jmax696/PillCard/docs/ER_Datenbank.png

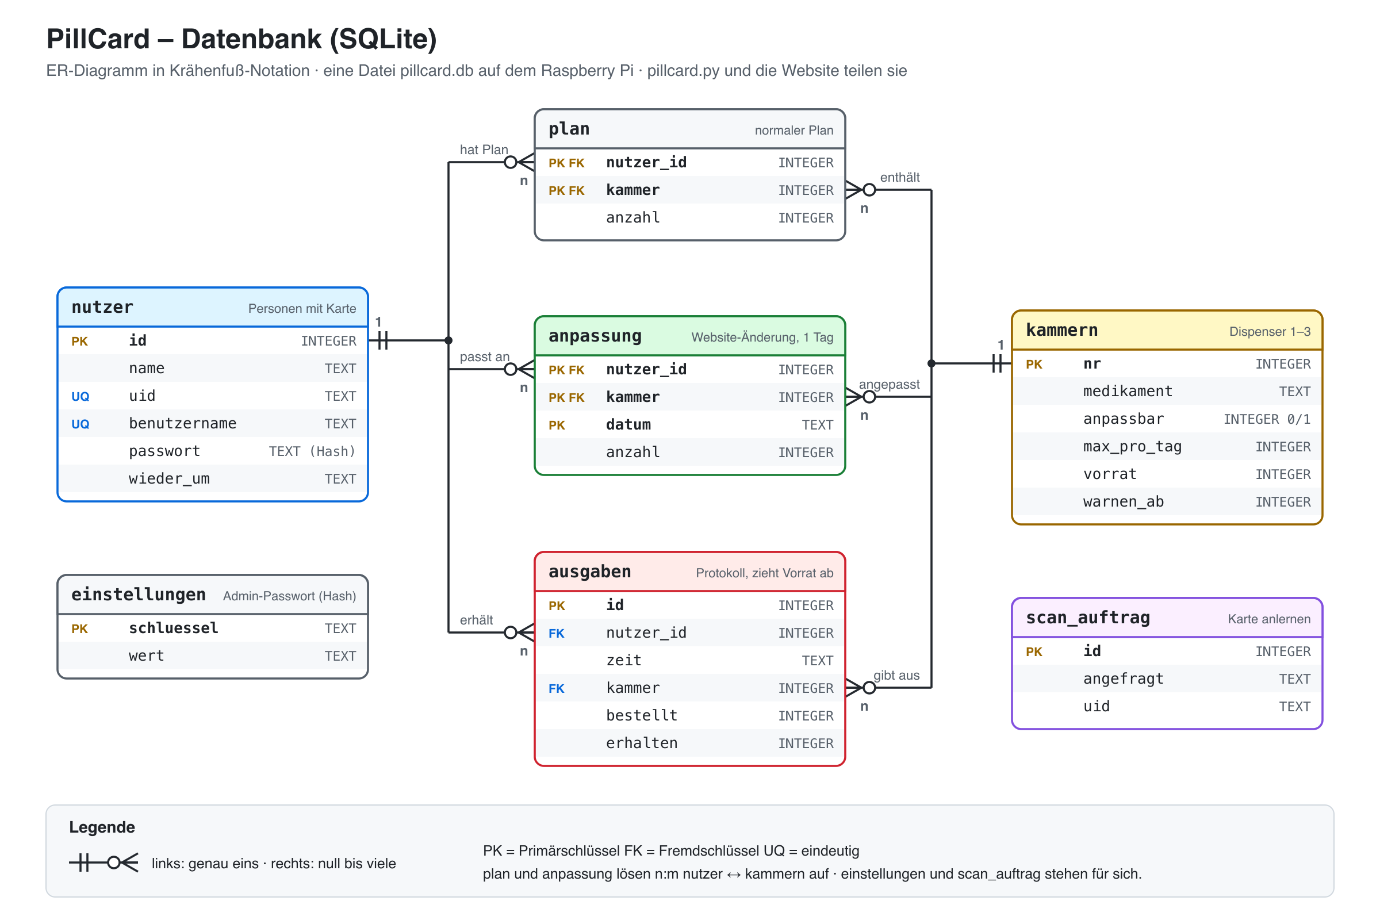
docs/ER_Datenbank.png
