jmax696/PillCard/docs/Schaltplan_ESP32.png

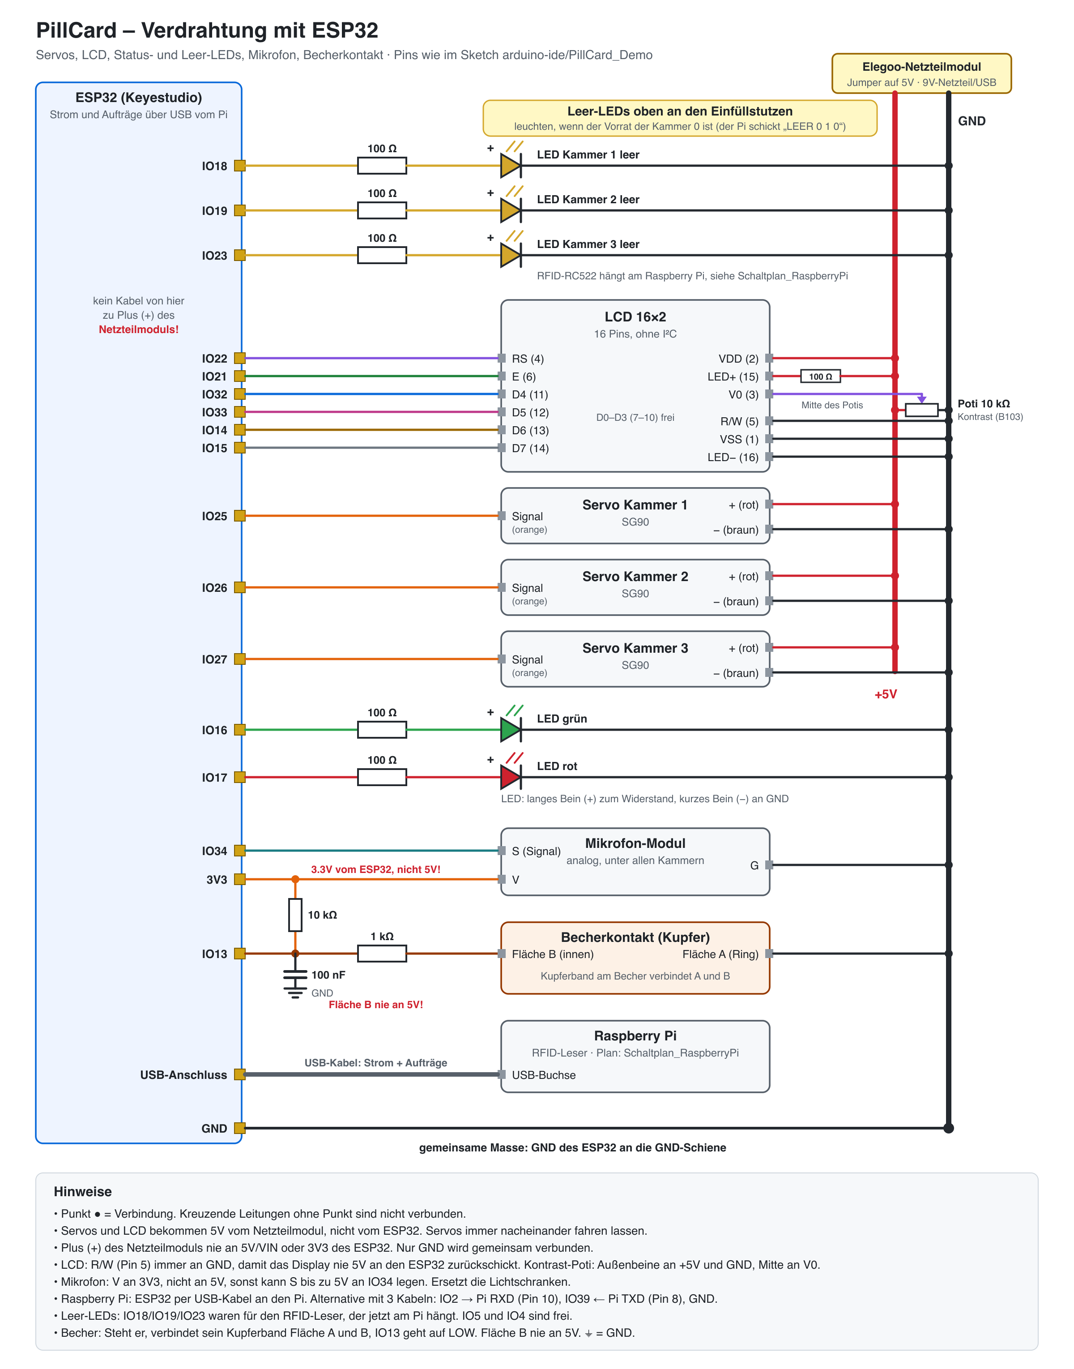
docs/Schaltplan_ESP32.png
