jmax696/PillCard/docs/Schaltplan_RaspberryPi.png

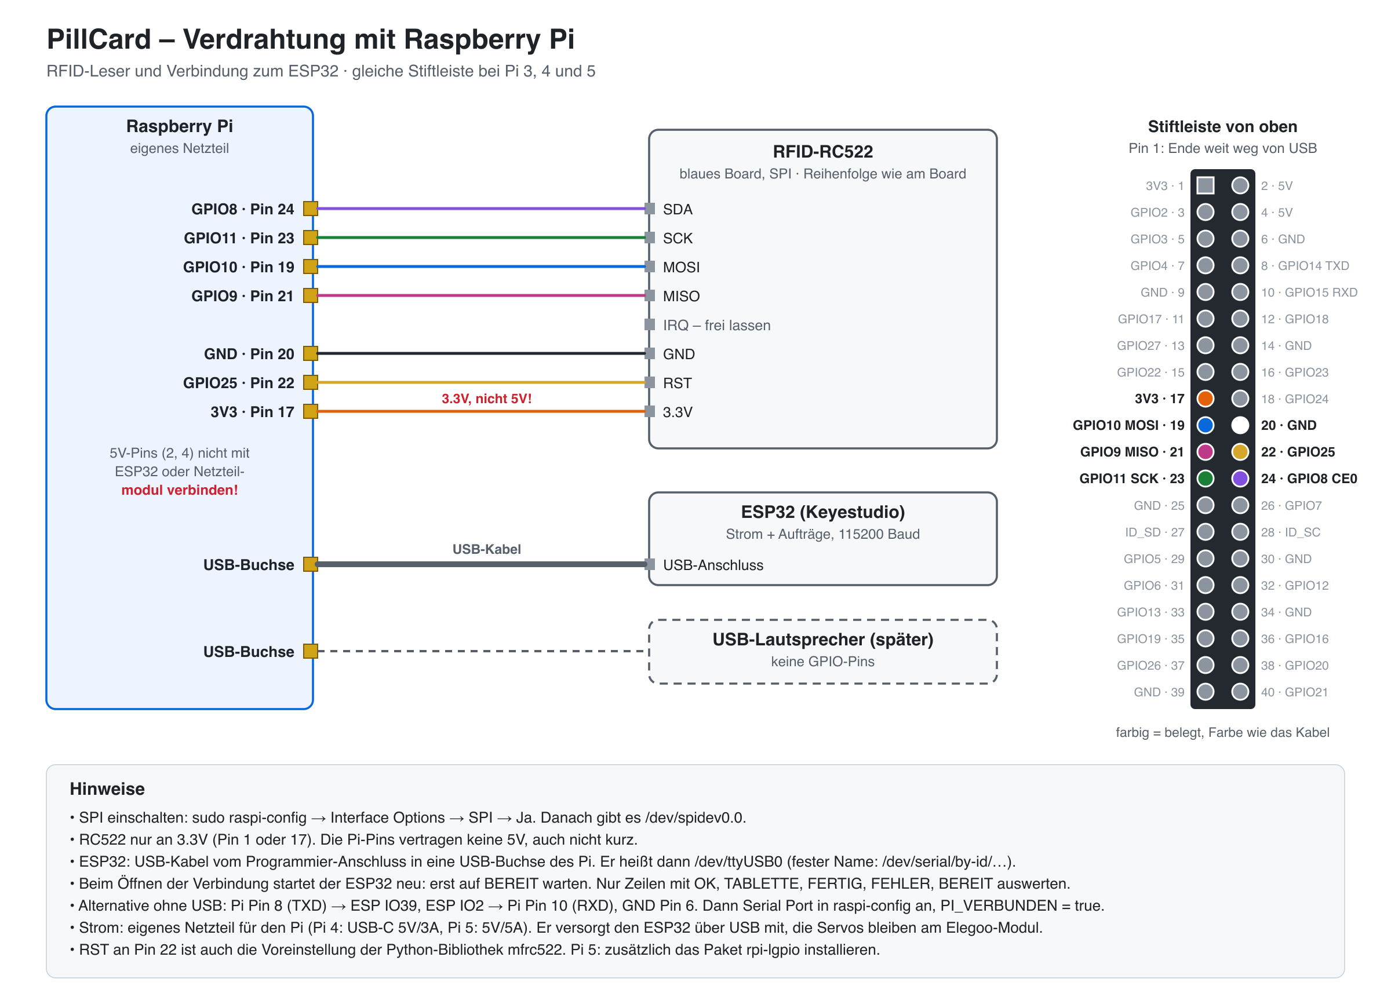
docs/Schaltplan_RaspberryPi.png
