jmax696/PillCard/docs/Test-Rezepte/A4_Rezept_Anna.pdf

# MUSTER

# PillCard Testpraxis

## Dr. med. Lena Muster

Fachärztin für Allgemeine Innere Medizin Torstrasse 25

- 9000 St. Gallen

GLN 7601000000000
Tel. 071 000 00 00 (Muster)

E-Rezept

- CHMED16A
Code mit der App scannen

# Rezept

Rezept-ID 00000000-0000-4000-8000-000000000010

PATIENTIN

## Anna Test

### geb. 01.01.2000

### - weiblich

Versichertenkarte: Muster, nicht hinterlegt

AUSGESTELLT
30.10.2026, 09:15

### St. Gallen

VERORDNETE MEDIKAMENTE

Medikament | Mo | Mi | Ab | Na | Hinweis | Pkg.

## Magnesium 300 mg Tabletten

Grund: Muskelkrämpfe | 1 | 0 | 1 | 0 | mit einem Glas Wasser

1

## Vitamin D3 1000 IE Tabletten

Grund: Vitamin-D-Mangel

1 | 0 | 0 | 0 | zum Frühstück

1

Mengen in Tabletten (Stück): Mo

= morgens, Mi

= mittags, Ab

= abends, Na

= nachts.

Dauertherapie bis auf Widerruf.

Dr. med. Lena Muster
Unterschrift (Muster)

PillCard Testpraxis St. Gallen

TESTREZEPT

– kein echtes E-Rezept (PillCard-Prototyp, HSG Hands-on HCI)

Erfundene Praxis und Personen, keine elektronische Signatur. Nicht in einer Apotheke einlösen.
QR-Code: Schweizer E-Rezept-Format CHMED16A1 (Version 20), liest die PillCard-Website unter Kammern

→ E-Rezept scannen.
