jmax696/PillCard/docs/Test-Rezepte/01_Anna_Eisen_Vitamin-C.png

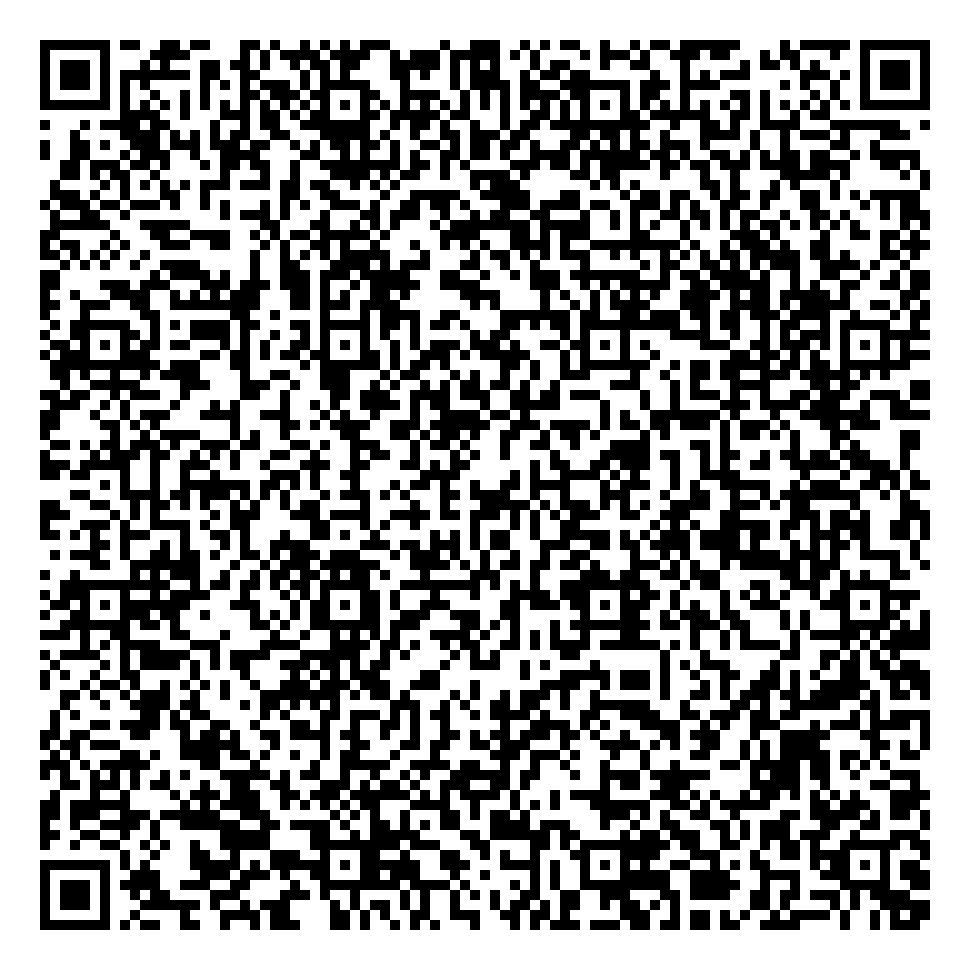
docs/Test-Rezepte/01_Anna_Eisen_Vitamin-C.png
