jmax696/PillCard/docs/Test-Rezepte/02_Kris_Zink.png

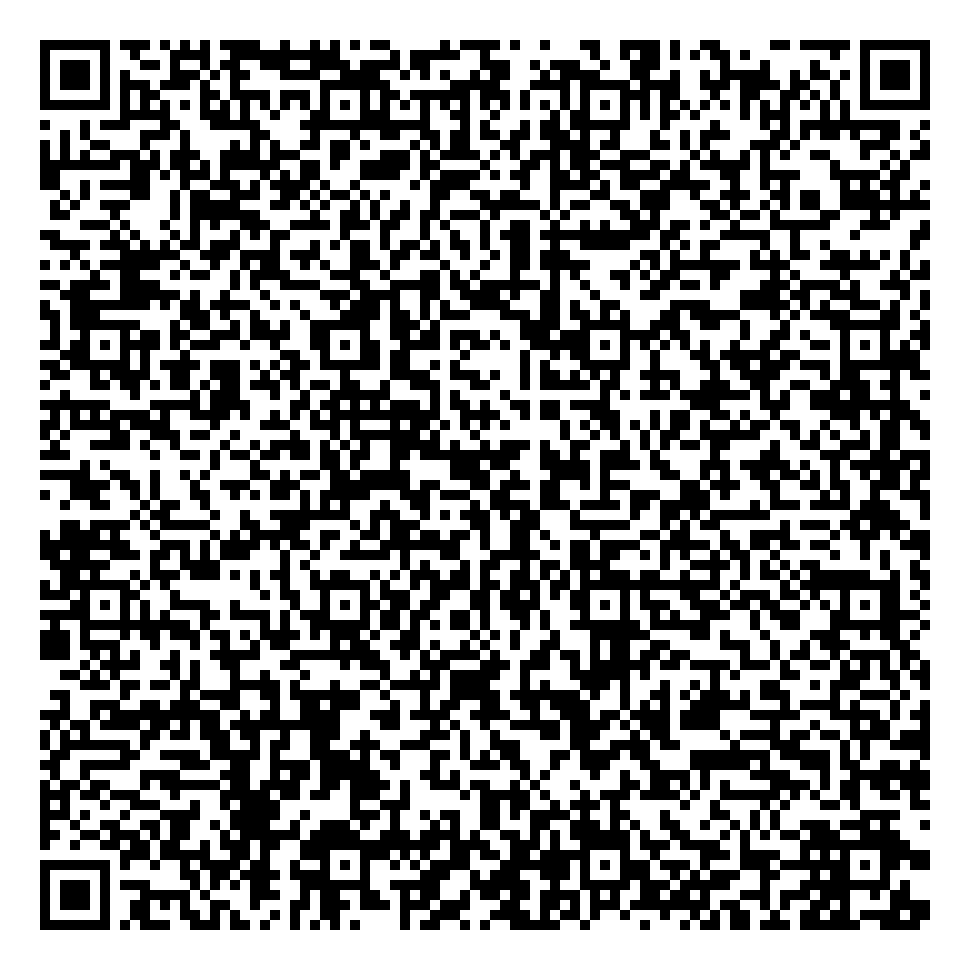
docs/Test-Rezepte/02_Kris_Zink.png
