jmax696/PillCard/docs/Test-Rezepte/03_Bruno_Calcium.png

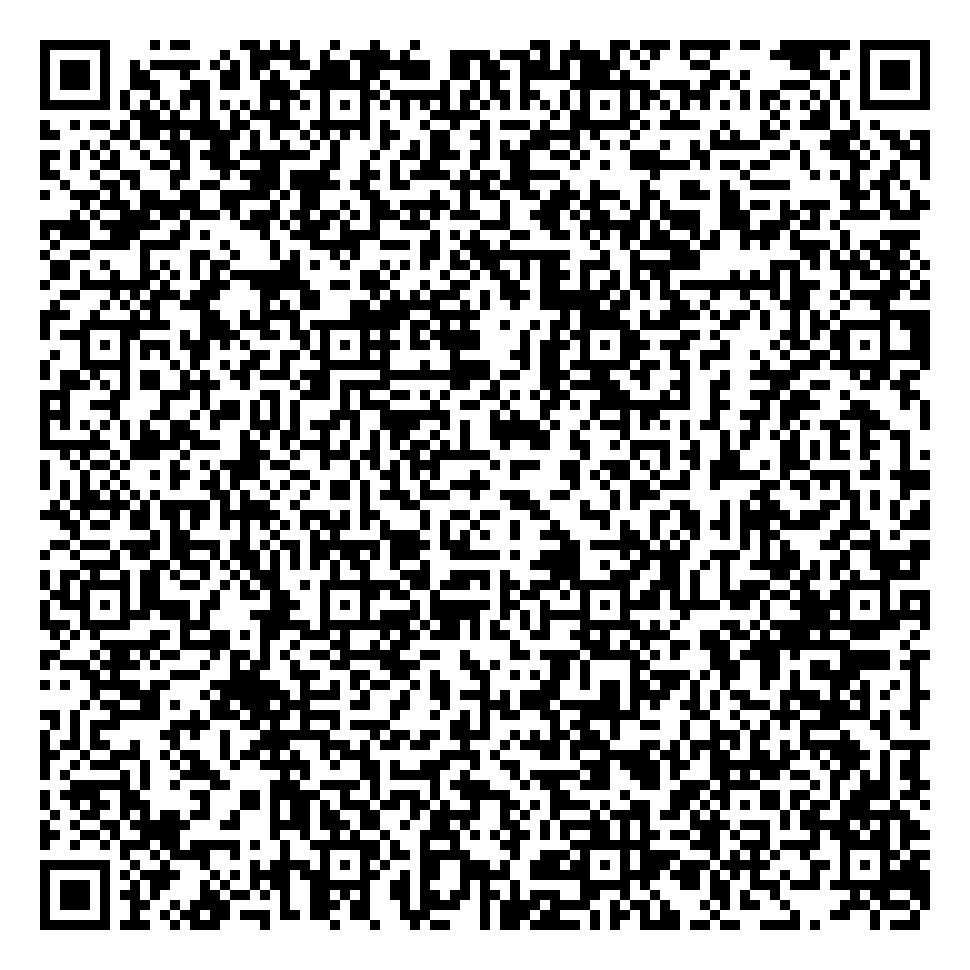
docs/Test-Rezepte/03_Bruno_Calcium.png
