jmax696/PillCard/docs/Test-Rezepte/04_Anna_Magnesium.png

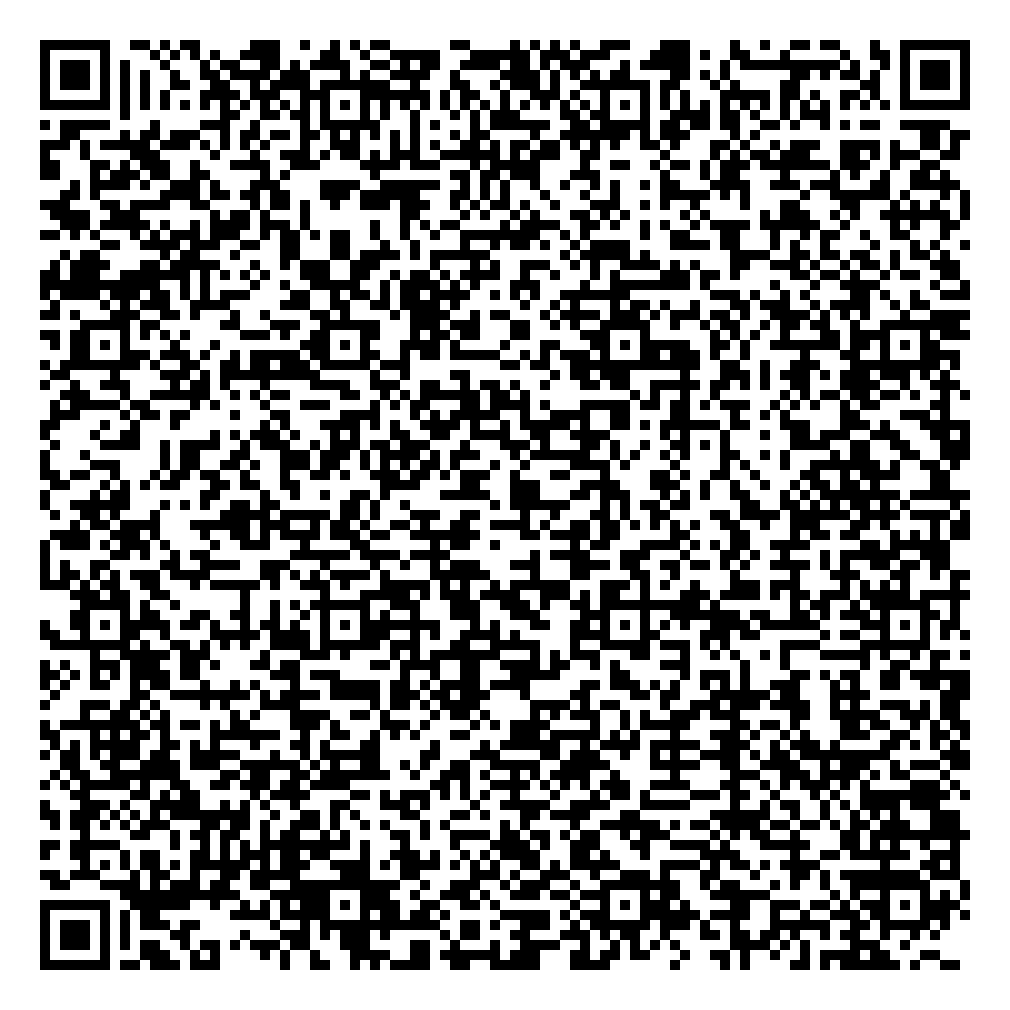
docs/Test-Rezepte/04_Anna_Magnesium.png
