jmax696/PillCard/docs/Test-Rezepte/05_Bruno_Vitamin-D.png

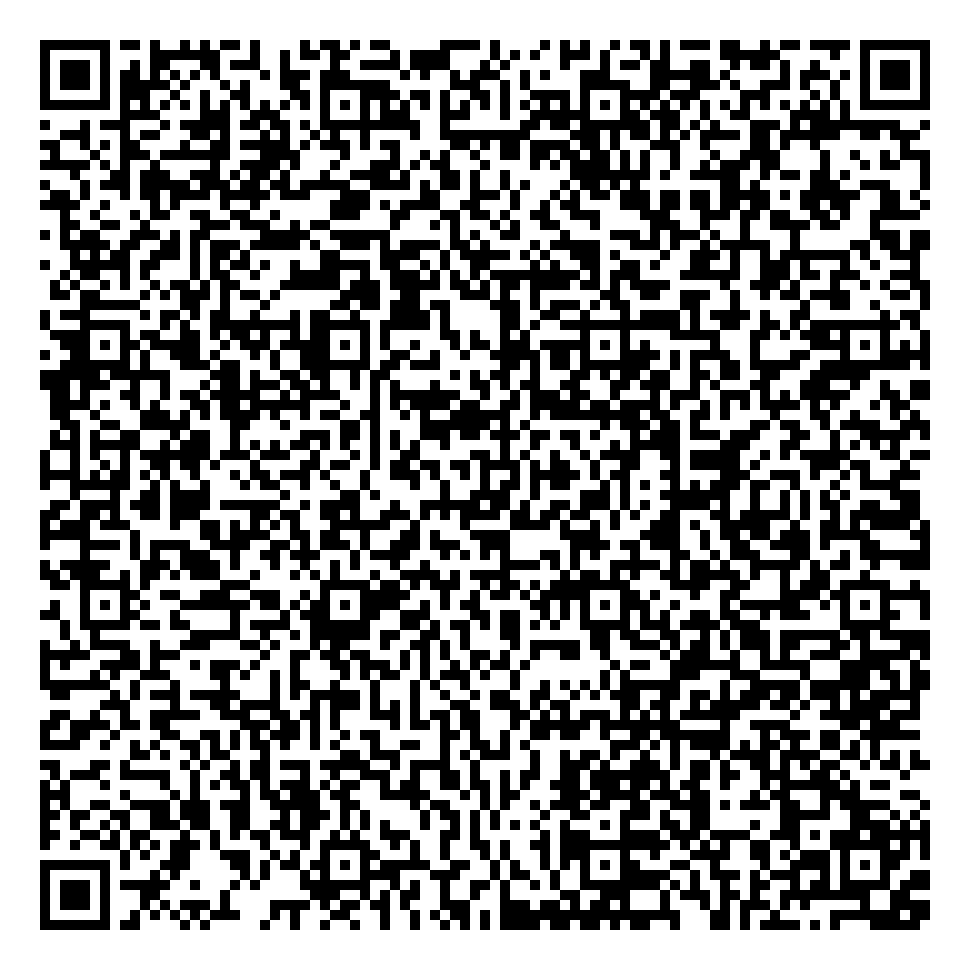
docs/Test-Rezepte/05_Bruno_Vitamin-D.png
