jmax696/PillCard/docs/Test-Rezepte/06_Kris_Omega-3.png

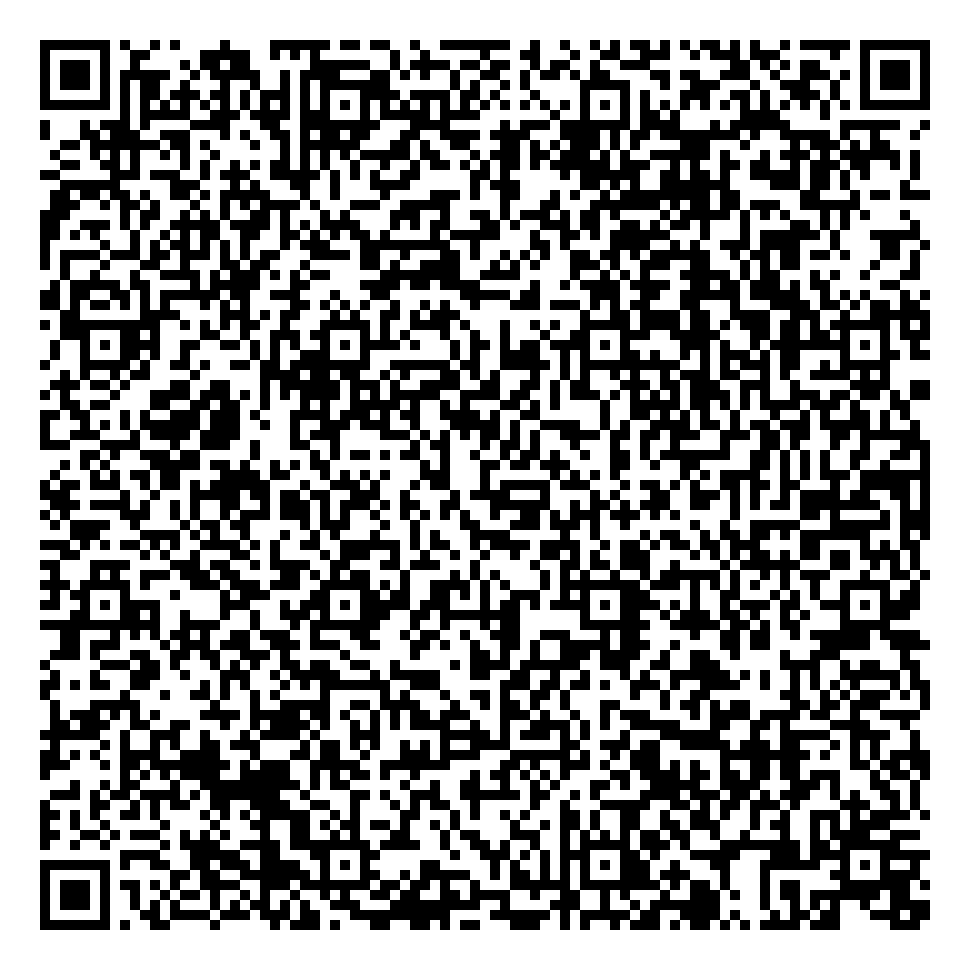
docs/Test-Rezepte/06_Kris_Omega-3.png
