jmax696/PillCard/docs/Test-Rezepte/07_Anna_nur-GTIN.png

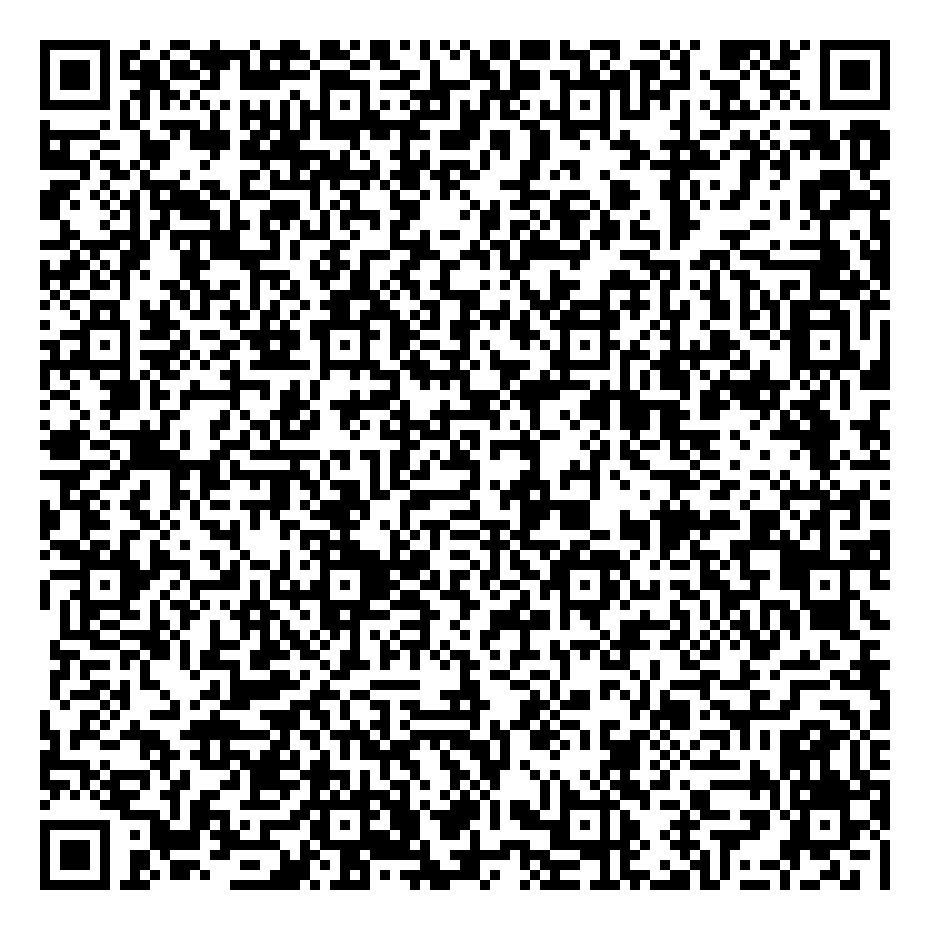
docs/Test-Rezepte/07_Anna_nur-GTIN.png
