jmax696/PillCard/docs/Test-Rezepte/08_Bruno_drei-Medikamente.png

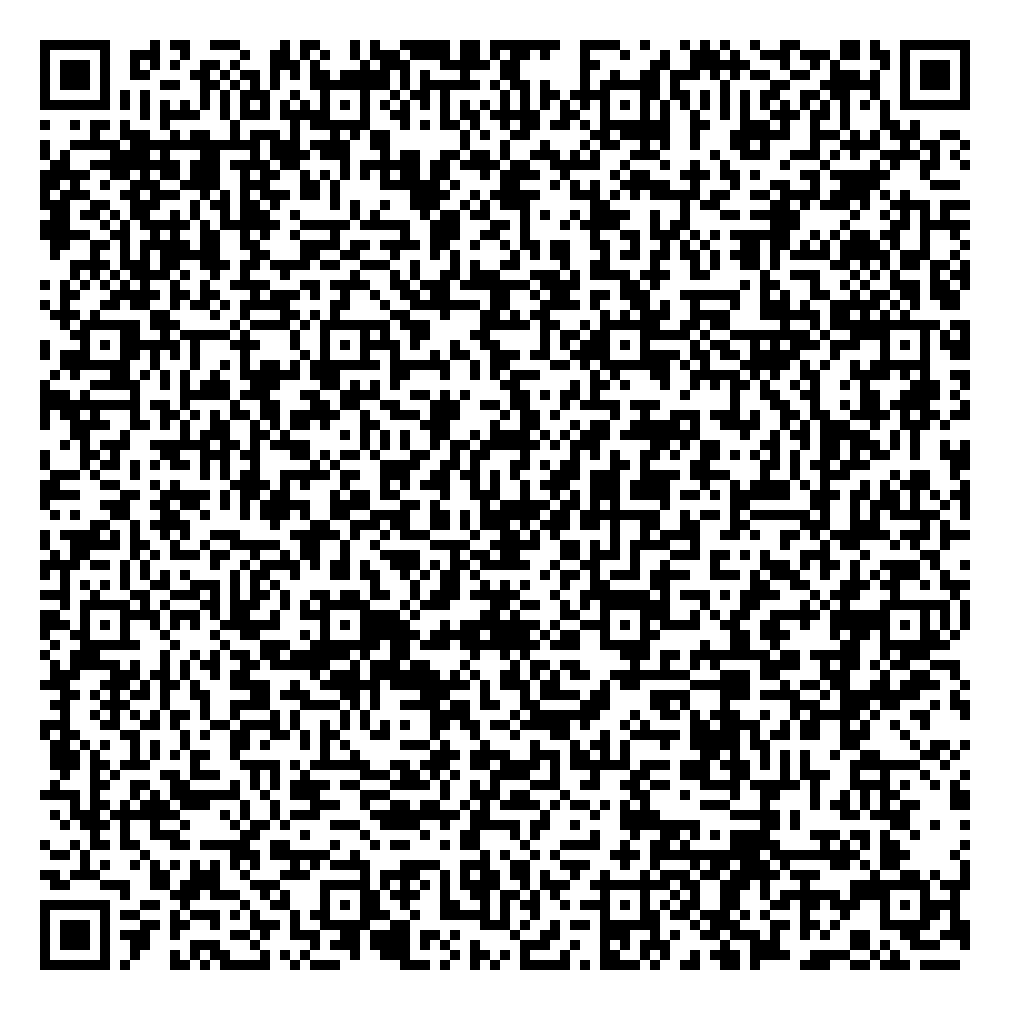
docs/Test-Rezepte/08_Bruno_drei-Medikamente.png
