jmax696/PillCard/docs/Test-Rezepte/09_Kris_Uhrzeit_halbe-Tablette.png

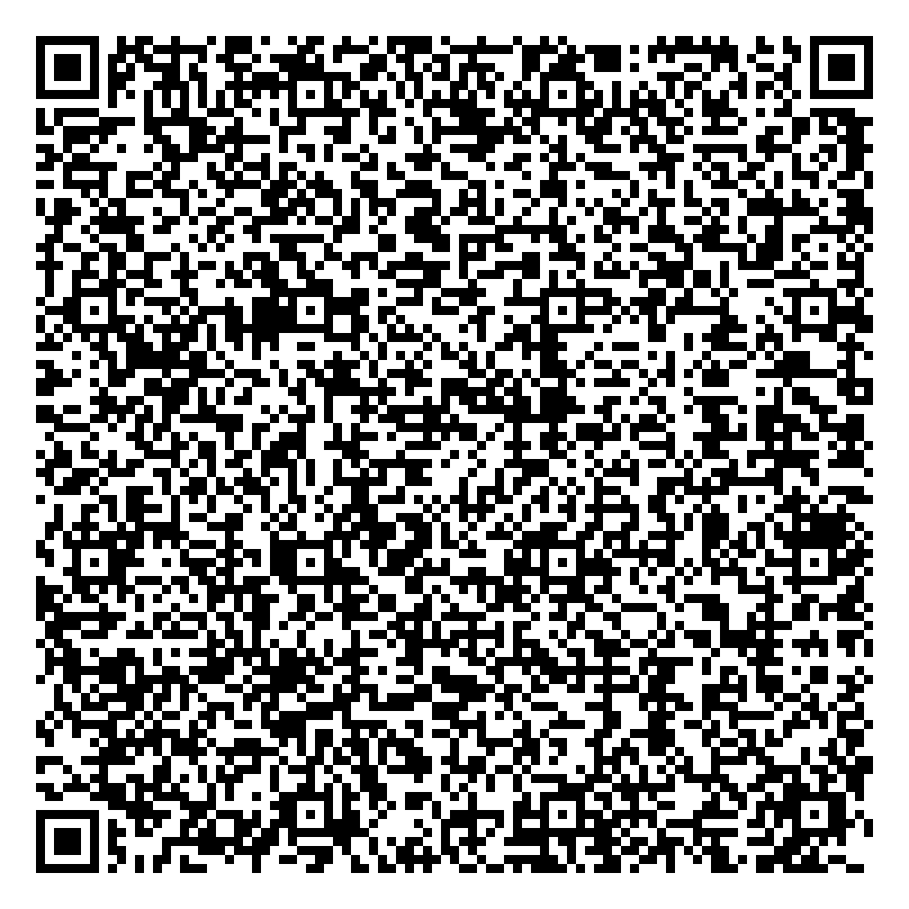
docs/Test-Rezepte/09_Kris_Uhrzeit_halbe-Tablette.png
