jmax696/PillCard/(commit log)

2026-10-27 README und Anforderungen für PillCard hinzufügen
2026-10-28 Demo-Sketch mit Mikrofon-Prüfung und Pläne für den Raspberry Pi
    - arduino-ide/PillCard_Demo: Karte und Chip geben aus verschiedenen Kammern aus,
    jede Tablette wird mit dem Mikrofon geprüft, Aufträge im Format für den Pi
    - Schaltplan_ESP32: Mikrofon (S/V/G) und spätere UART-Verbindung zum Pi
    - Schaltplan_RaspberryPi: RC522 und UART zum ESP32, Stiftleiste
    - Verkabelung.md: Abschnitt Raspberry Pi, Mikrofon statt Lichtschranken
2026-10-28 ESP32 per USB an den Raspberry Pi, Schaltpläne als PNG
    - Pi-Plan und ESP32-Plan: ein USB-Kabel für Strom und Aufträge,
    die drei UART-Kabel stehen als Alternative in den Hinweisen
    - Verkabelung.md: Einrichtung über USB, Hinweise fürs Pi-Programm,
    Abschnitt "Alternative: drei Kabel statt USB"
    - PillCard_Demo: Kommentare zur USB-Verbindung
    - Schaltplan_ESP32.png und Schaltplan_RaspberryPi.png (2400 px)
2026-10-28 Pi-Programm: Karte lesen und Aufträge an den ESP32 schicken
    - pi/pillcard.py: RC522 am Pi lesen, Plan aus plaene.json, Auftrag per USB
    an den ESP32, "heute schon genommen", Protokoll in ausgaben.csv
    - pi/plaene.json: Anna (Karte) Kammer 1+3, Bruno (Chip) Kammer 2+3
    - pi/start.sh, stop.sh: Autostart per cron mit Neustart nach Absturz
    - pi/esp_flashen.sh, esp_befehl.py: ESP32 vom Pi aus bespielen und testen
    - PillCard_Demo: RFID_AUF_ESP = false, Mikrofon-Test zeigt Rohwerte
2026-10-28 ER-Diagramm und Schema der geplanten SQLite-Datenbank
    - docs/ER_Datenbank.svg/.png: nutzer, kammern, plan, anpassung, ausgaben
    in Krähenfuß-Notation
    - docs/Datenbank.md: SQL-Schema, Abfrage für die heutige Dosis
    (Anpassung begrenzt durch max_pro_tag) und "heute schon genommen"
2026-10-28 Pi-Programm auf SQLite umgestellt
    - pi/datenbank.py: Tabellen aus dem ER-Diagramm, heutige Dosis per SQL
    (Anpassung begrenzt durch max_pro_tag), Import aus plaene.json und
    dem alten ausgaben.csv, "zeigen" für alle Tabellen
    - pi/pillcard.py: liest Pläne aus pillcard.db, trägt jede Ausgabe in
    "ausgaben" ein; stand.json und ausgaben.csv werden nicht mehr gebraucht
    - docs: Datenbank ist jetzt in Betrieb, nicht mehr nur geplant
2026-10-28 Lokale Website: Verwaltung mit Anlernen per Scan, Nutzerbereich mit Kalender
    - web.py (Flask/waitress, Port 8080): Nutzer anlernen und bearbeiten, Kammern und Vorrat,
    Login für Nutzer, Dosis nach Tagesform, Kalender, Vorratswarnung
    - Datenbank: benutzername, vorrat, warnen_ab, einstellungen, scan_auftrag (alte Dateien
    werden automatisch ergänzt), Ausgaben ziehen Vorrat ab
    - pillcard.py: Scan-Aufträge der Website, Wartezeit wächst mit der Anzahl Tabletten
    - Dosierung durch die Verwaltung frei 0-9 je Kammer, max_pro_tag nur für Selbstanpassung
    - ESP32 nimmt bis 9 Tabletten pro Kammer an
    - ER-Diagramm, Datenbank.md, neues Website.md
2026-10-28 Servo startet und endet sicher in Ruhelage, Kartenleser richtet sich nach Reset neu ein
    - ESP32: vor jeder Tablette erst in Ruhelage (300 ms), 800 ms für den Rückweg,
    Servo wird erst losgelassen, wenn die Kammer fertig ist
    - pillcard.py: prüft alle 2 s, ob der RC522 zurückgesetzt wurde (Antenne aus),
    und richtet ihn dann neu ein; Wartezeit 5 s pro Tablette
    [PillCard_Demo.ino, pillcard.py]
2026-10-29 Demo-Dashboard für die Präsentation, Nutzerbereich übersichtlicher
    Live-Dashboard unter /admin/demo (aktualisiert sich alle 2 s), Startseite des Nutzerbereichs mit Statuskarte, Morgen und Wochenleiste, Kalender mit Monatsbilanz, aktuelle Seite in der Navigation markiert.
2026-10-29 Servos für die neue 3D-Version: Ruhelage auf der anderen Seite, Servos bleiben angesteuert
    Demo-Sketch: Ruhe K1/K2 180°, K3 (IO27) 0°, Ausgabe bei allen 90°. Die Servos werden nicht mehr losgelassen, damit sie nicht aus der Ruhelage wandern. Test-Sketches und Hardware.h ebenfalls auf die andere Seite (Ruhe 180°, Kammer1_RFID Startwert 170°).
2026-10-29 Leer-LEDs an den Einfüllstutzen und E-Rezept-Scan für leere Kammern
    Ist der Vorrat einer Kammer 0, schickt pillcard.py dem ESP32 LEER 0 1 0 und die LED an IO18/IO19/IO23 geht an. Auf der Website lässt sich die Kammer per QR-Code eines E-Rezepts (CHMED16A, Foto oder Textfeld) neu belegen: Medikament, Tabletten pro Tag, Vorrat und Nutzer. Neue Tabelle rezepte, Test-QR-Codes in docs/Test-Rezepte, Schaltplan ohne RFID am ESP32, dafür mit den Leer-LEDs.
2026-10-29 Sechs weitere Test-Rezepte und Druckblatt mit allen QR-Codes
    04–06 einfache Fälle für Anna, Bruno und Kris, 07 nur mit GTIN wie ein echtes E-Rezept, 08 mit drei Medikamenten und Reserve, 09 mit Einnahmezeit und halber Tablette. Druckblatt.pdf: zwei Codes pro A4-Seite.
2026-10-30 Schaltplan ESP32: Kontrast-Poti am LCD und Becherkontakt an IO13 eingezeichnet
2026-10-30 Becherbestätigung pro Einnahme, Abholanzeige und Servo-Kalibrierung auf der Website
    - Neue Tabelle einnahmen: pro Auftrag Becher-Status (stand/abgebrochen/fehlte)
    und Entnahmezeit; ausgaben verweist über einnahme_id darauf
    - ESP32 meldet BECHER <nr> abgebrochen und BECHER <nr> genommen <s>;
    genommen erst, wenn der Becher 30 s weg ist
    - Display zeigt nach der Ausgabe "Ihre Medikation liegt bereit", bis der
    Becher genommen wird, beim Anheben "Bitte einnehmen"
    - Becher_Test-Sketch und Becherprüfung im Demo-Sketch
    - Servo-Kalibrierung über die Website (Tabelle servo_befehl, WINKEL-Befehl)
    - Doku: Datenbank, Verkabelung, Website, Agent-Kontext
2026-10-30 Test-Rezepte: ganzes A4-Rezept mit E-Rezept-QR-Code für die Demo
2026-10-30 Fehlt-Meldung in der App, Becher zurückstellen beendet Abholung, Mikrofon genauer
    - Display: "Fehlt: K2 / App öffnen" statt "Pflege rufen" (ö als eigenes Zeichen)
    - Website: Nutzerseite und Verwaltung melden heutige Tabletten, die nicht herauskamen
    - Becher abheben und wieder hinstellen beendet die Abholung, danach "Karte hinhalten"
    - Mikrofon: Fenster 1,8 s, Schwelle 200, kein zweiter Versuch
    - Pegelverlauf je Tablette steht im Pi-Log
2026-10-30 Display: "Karte unbekannt / App öffnen" und "Kein Becher / Becher abstellen" statt Pflege
